bgkatz/SPIne/SPIne_V2/SPIne/BOM.xlsx

Qty | Value | Package | Part | MFG Part Number | Digikey Number
1 |  | 43045-0400 | DC_IN | ‎0430450400‎ | ‎WM1814-ND‎
1 |  | MA20-1L | SV1 | ‎M20-7822046‎ | ‎952-1905-ND‎
4 | 120 | R0402 | R3, R5, R6, R7 | ‎CRGCQ0603F120R‎ | ‎A129677CT-ND‎
1 | DNP | R0402 | BYP
20 | .1 uF | C0603K | C1, C8, C12, C14, C16, C18, C19, C20, C21, C22, C23, C24, C4, C5, C6, C25, C27, C29, C31, C32 | ‎C0603C104M5RACTU‎ | ‎399-7845-1-ND‎
8 | 1uF | C0603 | C7, C41, C11, C13, C15, C17, C3, C10 | ‎UMK107AB7105KA-T‎ | ‎587-3247-1-ND‎
1 | 10 uF | C0805K | C30 | ‎GRM188R61E106MA73D‎ | ‎490-7202-1-ND‎
2 | 4.7 uF | C0603 | C2, C9 | ‎CL10A475MQ8NNNC‎ | ‎1276-1907-1-ND‎
5 | 47 uF | C1206K | C28, C33, C34, C35, C36 | ‎GRM32EC81C476KE15K‎ | ‎490-16309-1-ND‎
2 | 600r | 603 | CHOKE, CHOKE1 | ‎PE-0603FB601ST‎ | ‎553-2384-1-ND‎
2 | 200 | R0603 | R4, R22 | ‎RC0603JR-07200RL‎ | ‎311-200GRCT-ND‎
1 | 74AHC1G14DCK | SC70-5 | IC1 | SN74AHC1G14DCKR | 296-8748-1-ND
2 | BM07B-SRSS-TB | BM07B-SRSS-TB | PROG, PROG1 | ‎BM07B-SRSS-TB(LF)(SN)‎ | ‎455-1793-1-ND‎
2 | CSTCE | CSTCE | XT1, XT2 | CSTNE8M00GH5C000R0‎ | ‎490-17961-1-ND‎
2 | LED_RED | LED-0603 | LED2, LED4 | ‎LTST-C191KRKT‎ | ‎160-1447-1-ND‎
1 | LM1117 | SOT-223 | VR1 | LM1117MPX-3.3/NOPB | LM1117MPX-3.3/NOPBCT-ND
4 | ‎MCP2562-E/SN‎ | SO08 | U$4, U$5, U$6, U$7 | ‎MCP2562-E/SN‎ | ‎MCP2562-E/SN-ND‎
4 | SI8621EC-B-IS | SO08 | U$8, U$9, U$10, U$11 | SI8621EC-B-IS | 336-2066-5-ND
2 | STM32F446RET6 | TQFP64 | U$1, U$3 | ‎STM32F446RET6‎ | ‎497-15376-ND‎
4 | ‎CRE1S0505S3C‎ | 4SIL | DC1, DC2, DC3, DC4 | ‎CRE1S0505S3C‎ | ‎811-3195-ND‎
4 | 17mm hex standoff |  |  | ‎971170151‎ | ‎732-10424-ND‎
4 | 11mm hex standoff |  |  | ‎M2106-2545-AL‎ | ‎1772-2024-ND‎
1 | 40 pin |  |  | SSQ-120-02-T-D | SAM1193-20-ND
