bgkatz/SPIne/SPIne_V1/spine.brd

## EAGLE design SPIne_V1/spine.brd (2018-05-02, an earlier design)

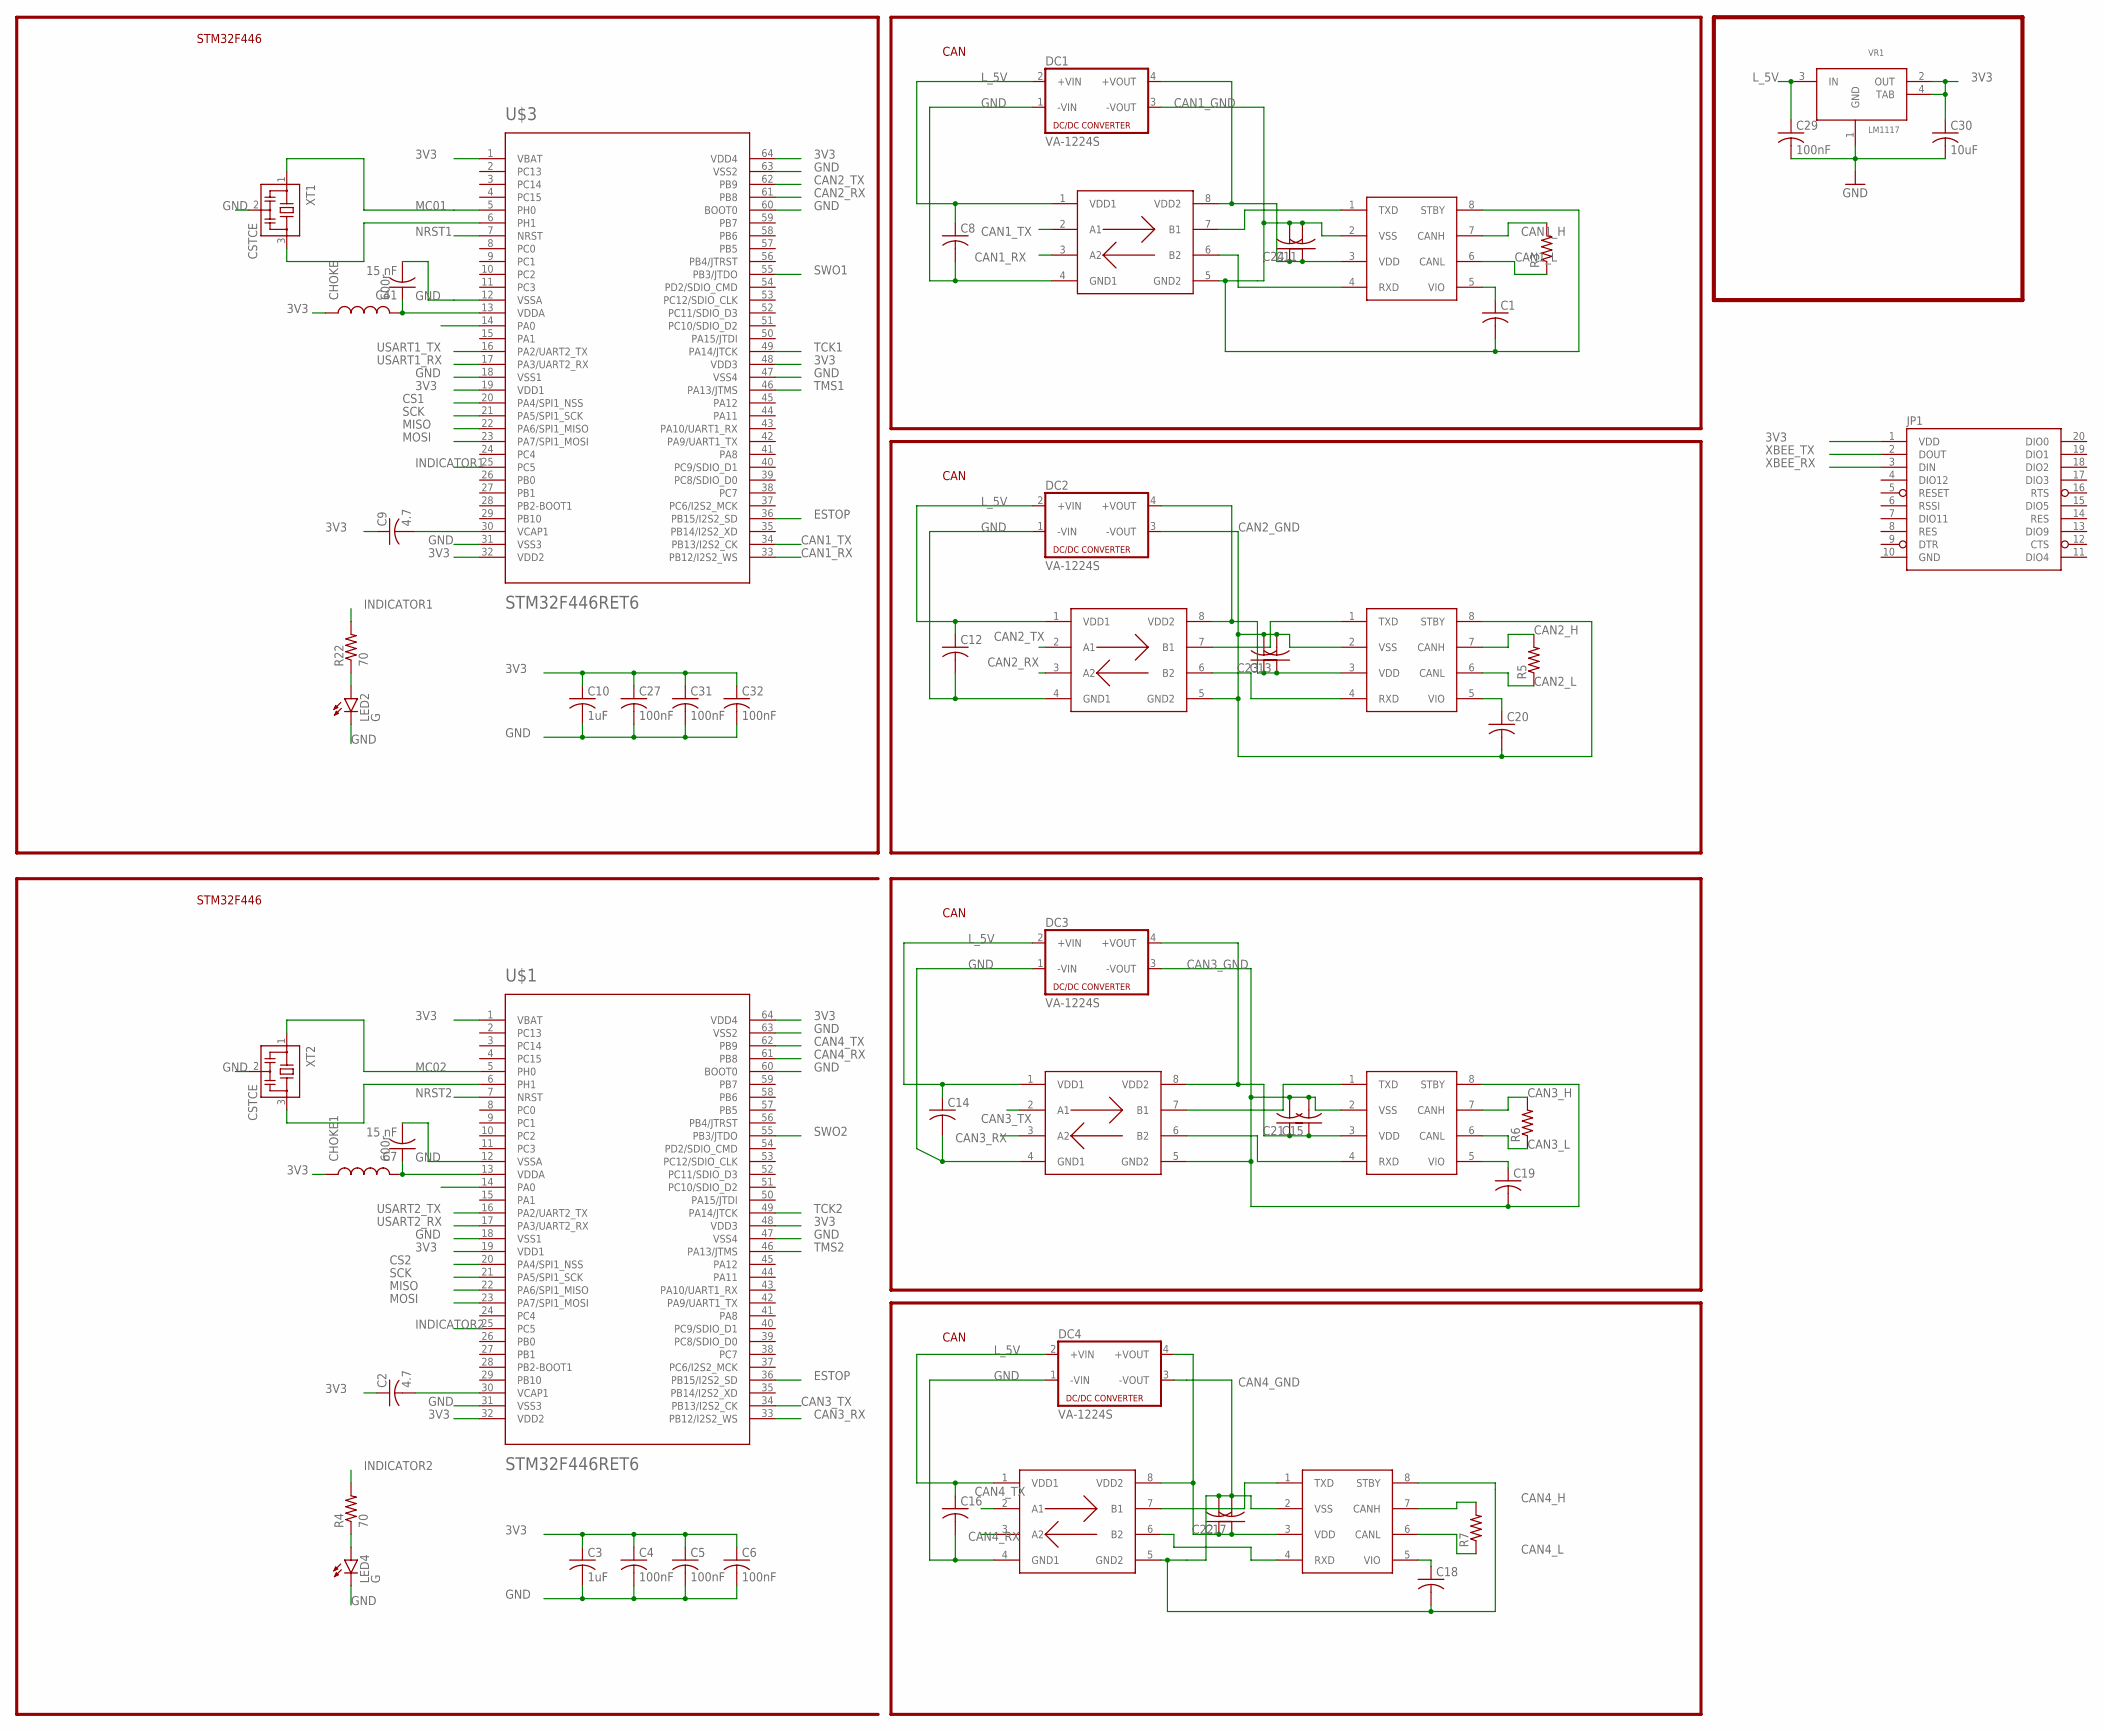
[picture p1: schematic spine.sch, sheet 1, Leg COM]

Parts:
C1, C8, C11, C12, C13, C14, C15, C16, C17, C18, C19, C20, C21, C22, C23, C24: C-USC0603K; C0603K
C2, C9: 4.7; C0603
C3, C10: 1uF; C0603
C4, C5, C6, C27, C29, C31, C32: 100nF; C0603
C7, C41: 15 nF; C0603
C30: 10uF; C0805K
CHOKE, CHOKE1: 600r; 0603
DC1, DC2, DC3, DC4: VA-1224S; 4SIL
JP1: XBEE-1B1; XBEE-1
LED2, LED4: G; LED-0603
R3, R5, R6, R7: R-US_R0603; R0603
R4, R22: 70; R0603
U$1, U$3: STM32F446RET6; TQFP64
U$4, U$5, U$6, U$7: MCP2561; SO08
U$8, U$9, U$10, U$11: SI8410; SO08
VR1: LM1117; SOT-223
XT1, XT2: CSTCE

Connections:
3V3: C2.1, C3.1, C4.1, C5.1, C6.1, C9.1, C10.1, C27.1, C30.1, C31.1, C32.1, CHOKE.1, CHOKE1.1, JP1.1 (VDD), U$1.1 (VBAT), U$1.19 (VDD1), U$1.32 (VDD2), U$1.48 (VDD3), U$1.64 (VDD4), U$3.1 (VBAT), U$3.19 (VDD1), U$3.32 (VDD2), U$3.48 (VDD3), U$3.64 (VDD4), VR1.2 (OUT), VR1.4 (TAB); also elsewhere on the board
CAN1_GND: C1.2, C11.2, C24.2, DC1.3 (-VOUT), U$4.2 (VSS), U$4.8 (STBY), U$8.5 (GND2); also elsewhere on the board
CAN1_H: R3.2, U$4.7 (CANH); also elsewhere on the board
CAN1_L: R3.1, U$4.6 (CANL); also elsewhere on the board
CAN1_RX: U$3.33 (PB12/I2S2_WS), U$8.3 (A2)
CAN1_TX: U$3.34 (PB13/I2S2_CK), U$8.2 (A1)
CAN2_GND: C13.2, C20.2, C23.2, DC2.3 (-VOUT), U$5.2 (VSS), U$5.8 (STBY), U$10.5 (GND2); also elsewhere on the board
CAN2_H: R5.2, U$5.7 (CANH); also elsewhere on the board
CAN2_L: R5.1, U$5.6 (CANL); also elsewhere on the board
CAN2_RX: U$3.61 (PB8), U$10.3 (A2)
CAN2_TX: U$3.62 (PB9), U$10.2 (A1)
CAN3_GND: C15.2, C19.2, C21.2, DC3.3 (-VOUT), U$6.2 (VSS), U$6.8 (STBY), U$9.5 (GND2); also elsewhere on the board
CAN3_H: R6.2, U$6.7 (CANH); also elsewhere on the board
CAN3_L: R6.1, U$6.6 (CANL); also elsewhere on the board
CAN3_RX: U$1.33 (PB12/I2S2_WS), U$9.3 (A2)
CAN3_TX: U$1.34 (PB13/I2S2_CK), U$9.2 (A1)
CAN4_GND: C17.2, C18.2, C22.2, DC4.3 (-VOUT), U$7.2 (VSS), U$7.8 (STBY), U$11.5 (GND2); also elsewhere on the board
CAN4_H: R7.2, U$7.7 (CANH); also elsewhere on the board
CAN4_L: R7.1, U$7.6 (CANL); also elsewhere on the board
CAN4_RX: U$1.61 (PB8), U$11.3 (A2)
CAN4_TX: U$1.62 (PB9), U$11.2 (A1)
CS1: U$3.20 (PA4/SPI1_NSS); also elsewhere on the board
CS2: U$1.20 (PA4/SPI1_NSS); also elsewhere on the board
ESTOP: U$1.36 (PB15/I2S2_SD), U$3.36 (PB15/I2S2_SD); also elsewhere on the board
GND: C3.2, C4.2, C5.2, C6.2, C7.2, C8.2, C10.2, C12.2, C14.2, C16.2, C27.2, C29.2, C30.2, C31.2, C32.2, C41.2, DC1.1 (-VIN), DC2.1 (-VIN), DC3.1 (-VIN), DC4.1 (-VIN), JP1.10 (GND), LED2.C, LED4.C, U$1.12 (VSSA), U$1.18 (VSS1), U$1.31 (VSS3), U$1.47 (VSS4), U$1.60 (BOOT0), U$1.63 (VSS2), U$3.12 (VSSA), U$3.18 (VSS1), U$3.31 (VSS3), U$3.47 (VSS4), U$3.60 (BOOT0), U$3.63 (VSS2), U$8.4 (GND1), U$9.4 (GND1), U$10.4 (GND1), U$11.4 (GND1), VR1.1 (GND), XT1.2, XT2.2; also elsewhere on the board
INDICATOR1: R22.2, U$3.25 (PC5)
INDICATOR2: R4.2, U$1.25 (PC5)
L_5V: C8.1, C12.1, C14.1, C16.1, C29.1, DC1.2 (+VIN), DC2.2 (+VIN), DC3.2 (+VIN), DC4.2 (+VIN), U$8.1 (VDD1), U$9.1 (VDD1), U$10.1 (VDD1), U$11.1 (VDD1), VR1.3 (IN); also elsewhere on the board
MC01: U$3.5 (PH0), XT1.1
MC02: U$1.5 (PH0), XT2.1
MISO: U$1.22 (PA6/SPI1_MISO), U$3.22 (PA6/SPI1_MISO); also elsewhere on the board
MOSI: U$1.23 (PA7/SPI1_MOSI), U$3.23 (PA7/SPI1_MOSI); also elsewhere on the board
unnamed: C41.1, CHOKE.2, U$3.13 (VDDA)
unnamed: C9.2, U$3.30 (VCAP1)
unnamed: C7.1, CHOKE1.2, U$1.13 (VDDA)
unnamed: C2.2, U$1.30 (VCAP1)
unnamed: C1.1, U$4.5 (VIO)
unnamed: LED4.A, R4.1
unnamed: U$1.6 (PH1), XT2.3
unnamed: C17.1, C22.1, DC4.4 (+VOUT), U$7.3 (VDD), U$11.8 (VDD2)
unnamed: C20.1, U$5.5 (VIO)
unnamed: C15.1, C21.1, DC3.4 (+VOUT), U$6.3 (VDD), U$9.8 (VDD2)
unnamed: C11.1, C24.1, DC1.4 (+VOUT), U$4.3 (VDD), U$8.8 (VDD2)
unnamed: U$4.1 (TXD), U$8.7 (B1)
unnamed: U$7.1 (TXD), U$11.7 (B1)
unnamed: U$4.4 (RXD), U$8.6 (B2)
unnamed: U$7.4 (RXD), U$11.6 (B2)
unnamed: C18.1, U$7.5 (VIO)
unnamed: C13.1, C23.1, DC2.4 (+VOUT), U$5.3 (VDD), U$10.8 (VDD2)
unnamed: U$5.1 (TXD), U$10.7 (B1)
unnamed: U$5.4 (RXD), U$10.6 (B2)
unnamed: C19.1, U$6.5 (VIO)
unnamed: U$6.1 (TXD), U$9.7 (B1)
unnamed: U$6.4 (RXD), U$9.6 (B2)
unnamed: LED2.A, R22.1
unnamed: U$3.6 (PH1), XT1.3
NRST1: U$3.7 (NRST); also elsewhere on the board
NRST2: U$1.7 (NRST); also elsewhere on the board
SCK: U$1.21 (PA5/SPI1_SCK), U$3.21 (PA5/SPI1_SCK); also elsewhere on the board
SWO1: U$3.55 (PB3/JTDO); also elsewhere on the board
SWO2: U$1.55 (PB3/JTDO); also elsewhere on the board
TCK1: U$3.49 (PA14/JTCK); also elsewhere on the board
TCK2: U$1.49 (PA14/JTCK); also elsewhere on the board
TMS1: U$3.46 (PA13/JTMS); also elsewhere on the board
TMS2: U$1.46 (PA13/JTMS); also elsewhere on the board
USART1_RX: U$3.17 (PA3/UART2_RX); also elsewhere on the board
USART1_TX: U$3.16 (PA2/UART2_TX); also elsewhere on the board
USART2_RX: U$1.17 (PA3/UART2_RX); also elsewhere on the board
USART2_TX: U$1.16 (PA2/UART2_TX); also elsewhere on the board
XBEE_RX: JP1.3 (DIN); also elsewhere on the board
XBEE_TX: JP1.2 (DOUT); also elsewhere on the board

Notes on the sheet:
STM32F446
CAN

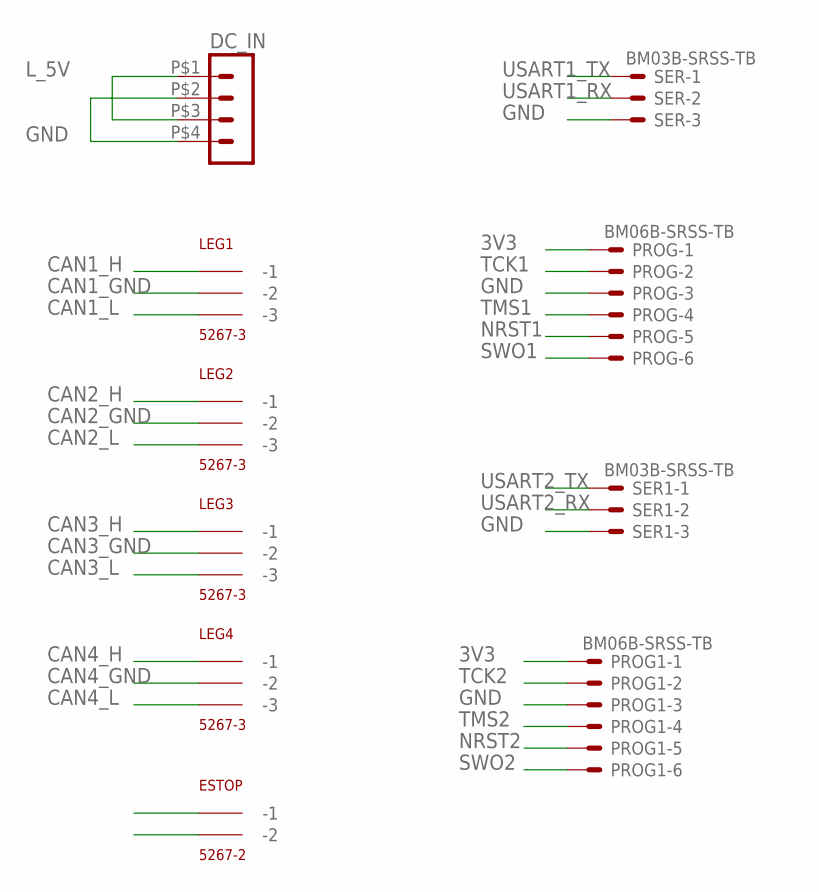
[picture p2: schematic spine.sch, sheet 2, Connectors]

Parts:
DC_IN: HEADER_POS4_43045-0401; 43045-0400
ESTOP: 5267-2
LEG1, LEG2, LEG3, LEG4: 5267-3
PROG, PROG1: BM06B-SRSS-TB
SER, SER1: BM03B-SRSS-TB

Connections:
3V3: PROG.1, PROG1.1; also elsewhere on the board
CAN1_GND: LEG1.P$2 (-2); also elsewhere on the board
CAN1_H: LEG1.P$1 (-1); also elsewhere on the board
CAN1_L: LEG1.P$3 (-3); also elsewhere on the board
CAN2_GND: LEG2.P$2 (-2); also elsewhere on the board
CAN2_H: LEG2.P$1 (-1); also elsewhere on the board
CAN2_L: LEG2.P$3 (-3); also elsewhere on the board
CAN3_GND: LEG3.P$2 (-2); also elsewhere on the board
CAN3_H: LEG3.P$1 (-1); also elsewhere on the board
CAN3_L: LEG3.P$3 (-3); also elsewhere on the board
CAN4_GND: LEG4.P$2 (-2); also elsewhere on the board
CAN4_H: LEG4.P$1 (-1); also elsewhere on the board
CAN4_L: LEG4.P$3 (-3); also elsewhere on the board
ESTOP: ESTOP.P$2 (-2); also elsewhere on the board
GND: DC_IN.P$2 (2), DC_IN.P$4 (4), ESTOP.P$1 (-1), PROG.3, PROG1.3, SER.3, SER1.3; also elsewhere on the board
L_5V: DC_IN.P$1 (1), DC_IN.P$3 (3); also elsewhere on the board
NRST1: PROG.5; also elsewhere on the board
NRST2: PROG1.5; also elsewhere on the board
SWO1: PROG.6; also elsewhere on the board
SWO2: PROG1.6; also elsewhere on the board
TCK1: PROG.2; also elsewhere on the board
TCK2: PROG1.2; also elsewhere on the board
TMS1: PROG.4; also elsewhere on the board
TMS2: PROG1.4; also elsewhere on the board
USART1_RX: SER.2; also elsewhere on the board
USART1_TX: SER.1; also elsewhere on the board
USART2_RX: SER1.2; also elsewhere on the board
USART2_TX: SER1.1; also elsewhere on the board

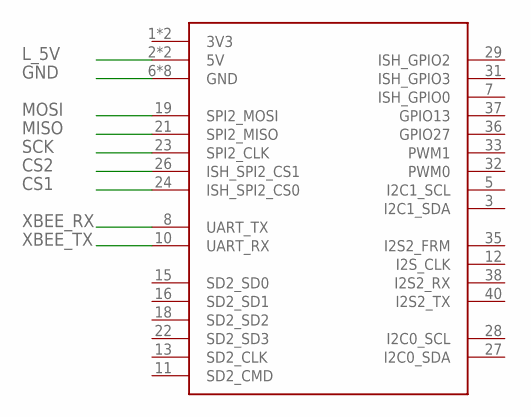
[picture p3: schematic spine.sch, sheet 3, UP Board]

Parts:
U$2: UP_BOARD

Connections:
CS1: U$2.24 (ISH_SPI2_CS0); also elsewhere on the board
CS2: U$2.26 (ISH_SPI2_CS1); also elsewhere on the board
GND: U$2.6 (GND), U$2.9 (GND), U$2.14 (GND), U$2.20 (GND), U$2.25 (GND), U$2.30 (GND), U$2.34 (GND), U$2.39 (GND); also elsewhere on the board
L_5V: U$2.2 (5V), U$2.4 (5V); also elsewhere on the board
MISO: U$2.21 (SPI2_MISO); also elsewhere on the board
MOSI: U$2.19 (SPI2_MOSI); also elsewhere on the board
SCK: U$2.23 (SPI2_CLK); also elsewhere on the board
XBEE_RX: U$2.8 (UART_TX); also elsewhere on the board
XBEE_TX: U$2.10 (UART_RX); also elsewhere on the board

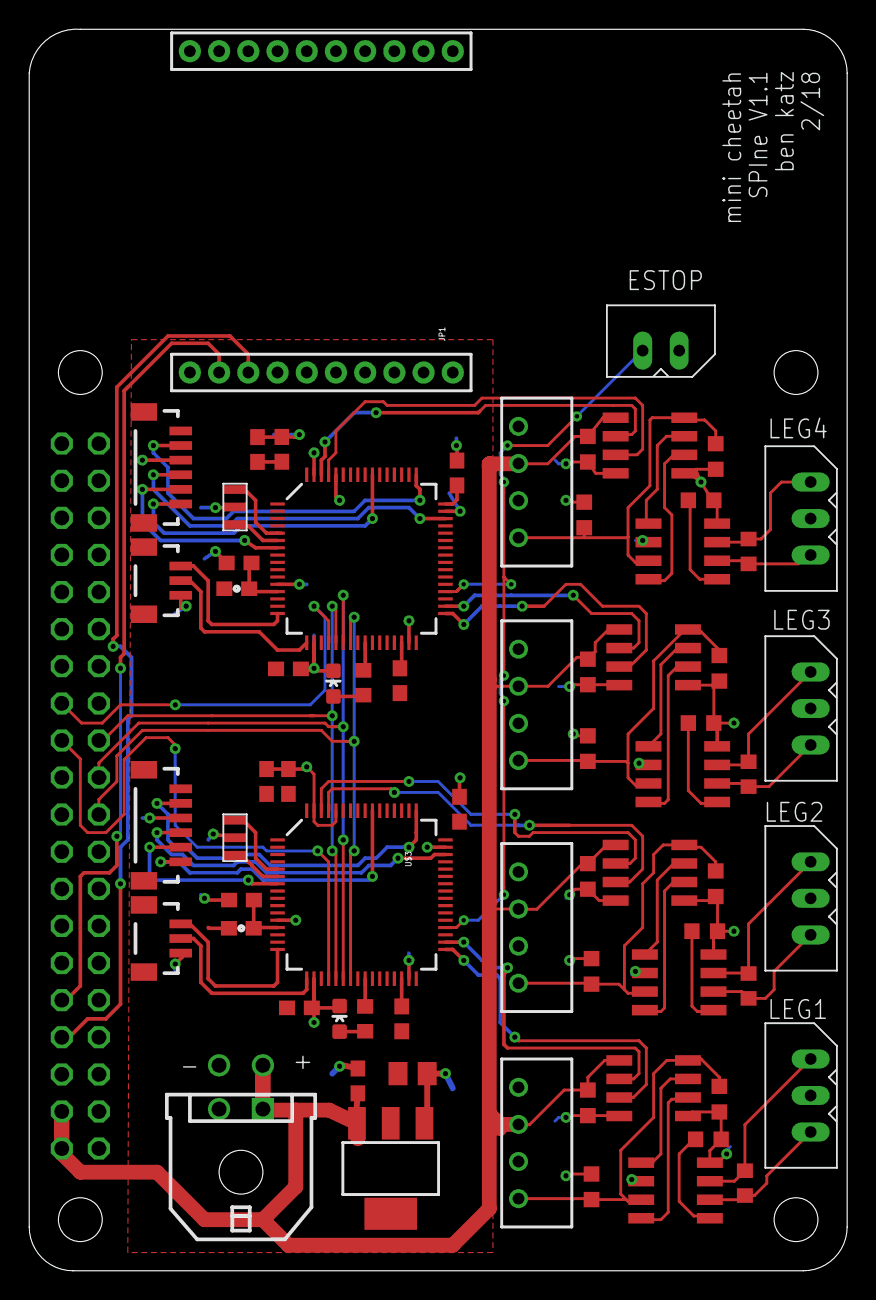
[picture p4: board spine.brd from above]

Board: 2 copper layers, 56.0 x 85.0 mm, 69 parts (0 on the bottom side), 71 nets.
