bgkatz/SPIne/SPIne_V2/ConnectorMezzanine/mc_spine_con.brd

## EAGLE design SPIne_V2/ConnectorMezzanine/mc_spine_con.brd (2019-09-12)

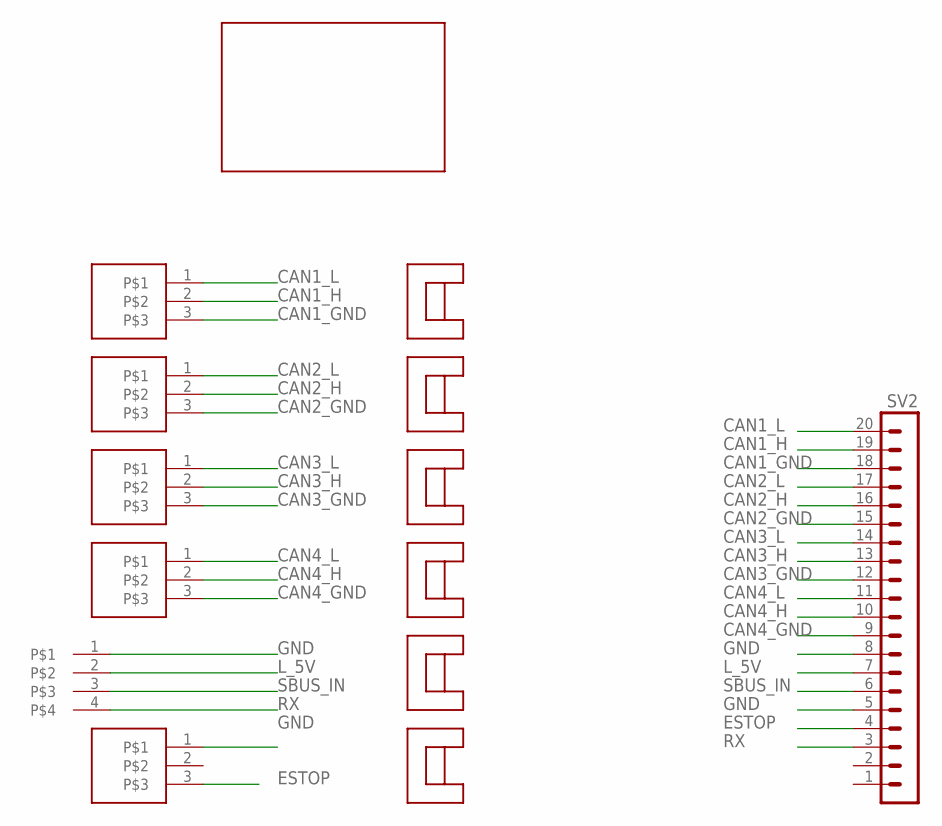
[picture p5: schematic mc_spine_con.sch]

Parts:
SV2: MA20-1L
U$1, U$3, U$4, U$6, U$12: 3-PIN; M80-8430342
U$2: UP_BOARD_NOPINS
U$5: 4-PIN; M80-8430442
U$7, U$8, U$9, U$10, U$11, U$13: SMD_CABLE_CLIPSS8111-46R; S8111-46R

Connections:
CAN1_GND: SV2.18, U$12.3
CAN1_H: SV2.19, U$12.2
CAN1_L: SV2.20, U$12.1
CAN2_GND: SV2.15, U$1.3
CAN2_H: SV2.16, U$1.2
CAN2_L: SV2.17, U$1.1
CAN3_GND: SV2.12, U$3.3
CAN3_H: SV2.13, U$3.2
CAN3_L: SV2.14, U$3.1
CAN4_GND: SV2.9, U$4.3
CAN4_H: SV2.10, U$4.2
CAN4_L: SV2.11, U$4.1
ESTOP: SV2.4, U$6.3
GND: SV2.5, SV2.8, U$5.1, U$6.1
L_5V: SV2.7, U$5.2
RX: SV2.3, U$5.4
SBUS_IN: SV2.6, U$5.3

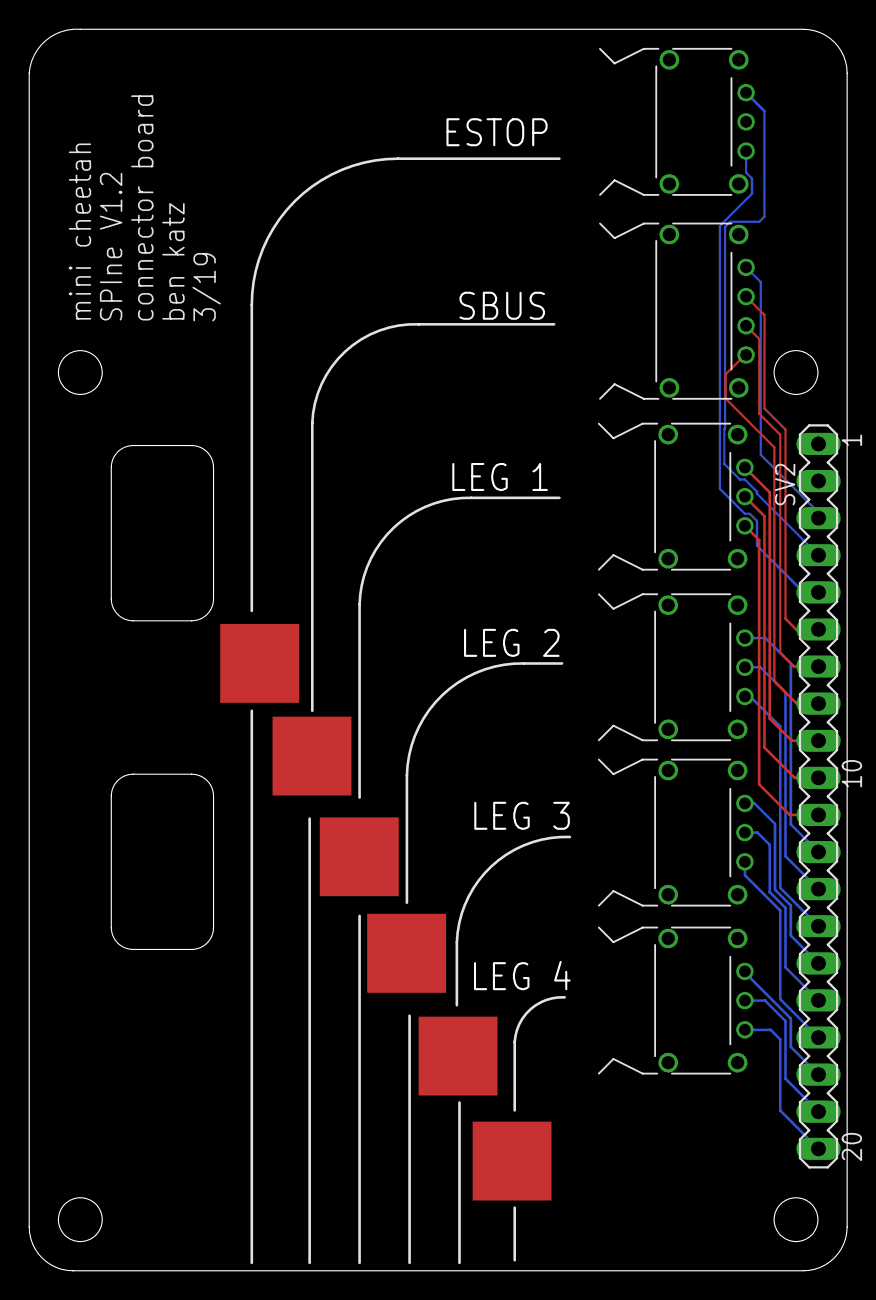
[picture p6: board mc_spine_con.brd from above]

Board: 2 copper layers, 56.0 x 85.0 mm, 14 parts (0 on the bottom side), 17 nets.
