bgkatz/SPIne/(commit log)

2018-05-02 Initial upload
    [spine.brd, spine.sch]
2019-09-12 added latest version with separate strain-relieved connector board
    [mc_spine_con.brd, mc_spine_con.sch, spine.brd, spine.sch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]
2020-10-09 updated BOM
    [BOM.xlsx]
